ATK-1/SeniorDesign_SwanGanz/README.md

# Swan Ganz Interface

### Introduction

The contributors to this senior design project were Nathan DeLaRosa, Ashton Knecht, Jack Son, and Jerry Xia under the supervision of Dr. Jonathan Valvano.

This project aims to create a custom, low-cost interface for a Swan-Ganz heart catheter, bypassing the need for expensive cardiac output computers. The catheters intended to be interfaced are the *part number needed* produced by Edwards Lifescience. These catheters interface the *part number needed* pressure transducer, also made by Edwards Lifescience.

The project is split into three sections: the interface hardware, MSPM0 firmware, and the desktop application software. Details about each of these sections can be found in their distinct README files.

[Hardware README(In Progresss)](https://github.com/ATK-1/SeniorDesign_SwanGanz/blob/main/hardware/README.md)

[Firmware README(Requires Development)](https://github.com/ATK-1/SeniorDesign_SwanGanz/blob/main/firmware/README.md)

[Software README(Requires Development)](https://github.com/ATK-1/SeniorDesign_SwanGanz/blob/main/SwanGanzApp/README.md)

### Testing and Verification
*todo*
