ATK-1/SeniorDesign_SwanGanz/firmware/SwanGanz/inc/fftdesign.xlsx

Sheet: cos
speed up using table look up
w.Real = cos(2*PI*m/(float)n);
w.Imag = -sin(2*PI*m/(float)n);
n is 2,4,8,16,32,64,128,256,512,1024,2048,4096
m goes from 0 to n/2
w.Real | n, j=0 | 1 | 2 | 3 | 4 | 5 | 6 | 7 | 8 | 9 | 10 | 11
m | 2 | 4 | 8 | 16 | 32 | 64 | 128 | 256 | 512 | 1024 | 2048 | 4096
0 | 1.00000000 | 1.00000000 | 1.00000000 | 1.00000000 | 1.00000000 | 1.00000000 | 1.00000000 | 1.00000000 | 1.00000000 | 1.00000000 | 1.00000000 | 1.00000000 | const float cosTab[2048][12]={
1 | -1.00000000 | 6.125742275e-17 | 0.70710678 | 0.92387953 | 0.98078528 | 0.99518473 | 0.99879546 | 0.99969882 | 0.99992470 | 0.99998118 | 0.99999529 | 0.99999882 | {1.00000000, 1.00000000, 1.00000000, 1.00000000, 1.00000000, 1.00000000, 1.00000000, 1.00000000, 1.00000000, 1.00000000, 1.00000000, 1.00000000},
2 | 1.00000000 | -1.00000000 | 6.125742275e-17 | 0.70710678 | 0.92387953 | 0.98078528 | 0.99518473 | 0.99879546 | 0.99969882 | 0.99992470 | 0.99998118 | 0.99999529 | {-1.00000000, 0.00000000, 0.70710678, 0.92387953, 0.98078528, 0.99518473, 0.99879546, 0.99969882, 0.99992470, 0.99998118, 0.99999529, 0.99999882},
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
