ATK-1/SeniorDesign_SwanGanz/hardware/SGI_BOM_v1.0.xlsx

Reference | Part Number | Quantity | Mouser PN | Manufacturer | Value | Rating | Footprint | Tolerance | Type | Price for 1
C1, C3, C4, C5, C6, C7, C8, C9, C10, C13, C14, C17, C18, C21 | CC0603JRX7R9BB104 | 14 | 603-CC0603KRX7R9BB104 | YAGEO | 0.1uF | 50 VDC | 0603 | 5% | X7R | $0.10
C2 | C1206C106J3RACTU | 1 | 80-C1206C106J3RACTU | KEMET | 10uF | 25 VDC | 1206 | 5% | X7R | $0.94
C11, C12, C15, C16, C19, C20 | GRT31C5C1H104FA02L | 6 | 81-GRT31C5C1H104FA2L | Murata | 0.1uF | 25 VDC | 1206 | 1% | C0G | $0.91
D1, D2, D3 | HLMP-4700 | 3 | 630-HLMP-4700 | Broadcom/Avago | Red
Q1 | SQ2389CES-T1_GE3 | 1 | 78-SQ2389CES-T1_GE3 | Vishay/Siliconix | N/A | 40 Vds | SOT-23-3 | N/A | P-channel | $0.68
R1, R2 | CR0603-FX-5101ELF | 2 | 652-CR0603FX-5101ELF | Bourns | 5.1k | 75 V | 0603 | 1% | Thick film | $0.10
R3 | CRCW060347K0FKED | 1 | 71-CRCW060347K0FKED | Vishay | 47k | 75 V | 0603 | 1% | Thick film | $0.25
R4,R20, R21, R22, R23, R27, R28, R29, R34, R35, R36 | RCA060310K0FKEC | 11 | 71-RCA060310K0FKEC | Vishay/Draloric | 10k | 75 V | 0603 | 1% | thick film | $0.11
R5 | TNPW06031K00FHTA | 1 | 71-TNPW06031K00FHTA | Vishay | 1k | 75 V | 0603 | 1% | thin film | $0.39
R6, R7, R8 | 1879246-3 | 3 | 571-1879246-3 | TE Connectivity | 5k | 50 V | 0603 | 1% | thin film | $0.31
R9, R14, R16 | RCA0603100KFKEC | 4 | 71-RCA0603100KFKEC | Vishay | 100k | 75 V | 0603 | 1% | Thick film | $0.11
R10, R13 | AC0603FRE07100RL | 2 | 603-AC0603FRE07100RL | YAGEO | 100 | 75 V | 0603 | 1% | Thick film | $0.10
R11, R12 | CRCW06030000Z0EI | 2 | 71-CRCW06030000Z0EI | Vishay | 0 | 75 V | 0603 | N/A | Thick film | $0.21
R15 | CR0603-FX-8201ELF | 1 | 652-CR0603FX-8201ELF | Bourns | 8.2k | 75 V | 0603 | 1% | Thick film | $0.10
R17 | RT0603DRD0765K5L | 1 | 603-RT0603DRD0765K5L | YAGEO | 65.5k | 75 V | 0603 | 0.5% | thin film | $0.10
R18, R19 | RT0603DRE07160KL | 2 | 603-RT0603DRE07160KL | YAGEO | 160k | 75 V | 0603 | 0.5% | thin film | $0.11
R24, R31 | RC0603FR-10200RL | 2 | 603-RC0603FR-10200RL | YAGEO | 200 | 75 V | 0603 | 1% | Thick film | $0.12
R25, R26, R32, R33 | RN73R1JTTD3202F50 | 4 | 660-RN73R1JTD3202F50 | KOA SPEER | 32k | 75 V | 0603 | 1% | thin film | $0.10
R30, R37 | CRCW060317K4FKEAC | 2 | 71-CRCW060317K4FKEAC | Vishay | 17.4k | 75 V | 0603 | 1% | thick film | $0.10
SW1 |  | 1
SW2, SW3 |  | 2
U8, U10, U12 | INA122UA/2K5 | 3 | 595-INA122UA/2K5 | Texas Instruments | N/A | N/A | SOIC-8 | N/A | IC | $6.72
