ATK-1/SeniorDesign_SwanGanz/hardware/SwanGanzInterface_V1.1/SwanGanzInterface_v1.1_PinAllocation.xlsx

Sheet: Device Comparision
Part Number | Flash (KB) | SRAM (KB) | ADC | ADC Channels | COMP | TIMA | TIMG | GPIO | Number of Pins | Package | Size
M0G3507QPMRQ1 | 128 | 32 | 2 | 17 | 3 | 2 | 5 | 60 | 64 | 64 LQFP | 12mm x 12mm
M0G3507QPTRQ1 | 128 | 32 | 2 | 16 | 3 | 2 | 5 | 44 | 48 | 48 LQFP | 9mm x 9mm
M0G3507QRGZRQ1 | 128 | 32 | 2 | 16 | 3 | 2 | 5 | 44 | 48 | 48 VQFN | 7mm x 7mm
M0G3507QRHBRQ1 | 128 | 32 | 2 | 11 | 3 | 2 | 5 | 28 | 32 | 32 VQFN | 5mm x 5mm
M0G3507QDGS32RQ1 | 128 | 32 | 2 | 11 | 3 | 2 | 5 | 28 | 32 | 32 VSSOP | 8.1mm x 4.9mm
M0G3507QDGS28RQ1 | 128 | 32 | 2 | 11 | 3 | 2 | 5 | 24 | 28 | 28 VSSOP | 7.1mm x 3mm

Sheet: Pin Requirements
Pin Name | QTY | Discription | TRM SECTION | TRM PAGE | PT - Assigned
HFXTIN | 1 | Input for high-frequency crystal oscillator | 2.3.1.6 High Frequency Crystal Oscillator (HFXT) | 231
HFXOUT | 1 | Output for high-frequency crystal oscillator | 2.3.1.6 High Frequency Crystal Oscillator (HFXT) | 231
ROSC | 1 | External resistor used for improiving oscillator accuracy
Therm_ADC | 2 | ADC inputs for thermistor circuit
P1_ADC | 2 | ADC inputs for p1 circuit
P2_ADC | 2 | ADC inputs for p2 circuit
LCD_SCLK | 1 | SPI SysClk for LCD driver
LCD_MISO | 1 | SPI MISO for LCD driver
LCD MOSI | 1 | SPI MOSI for LCD driver
LCD_CS | 1 | GPIO chip select for LCD driver
LCD_RST | 1 | GPIO reset for LCD driver
LCD_WAIT | 1 | GPIO input specifiying the busy state of the LCD driver
LCD_INT | 1 | GPIO input specifiying the interrupt status of LCD driver
LCD_TS | 4 | ADC inputs for LCD touch screen
UART_Rx | 1 | UART receive for UART to USB converter
UART_Tx | 1 | UART transmit for UART to USB converter
USB_CONN | 1 | GPIO input to determine if USB is connected
SW_IN | 2 | GPIO inputs for tactile switches
LED | 2 | GPIO outputs to control LED outputs
Debug GPIO | 8 | GPIO outputs for debugging
SWCLK | 1 | Serial wire debug input clock
SWDIO | 1 | Serial wire debug data input/output
Total | 37

Sheet: PM - 64 LQFP
Pin | Pin Function | SGI v1.1 Function | Pin Function Select | Placed
1 | PB13 | LCD_Backlite | GPIO - Output
2 | PB14 | DBG1 | GPIO - Output
3 | PB15 | DBG2 | GPIO - Output
4 | PB16 | DBG3 | GPIO - Output
5 | PA12 / FCC_IN | DBG4 | GPIO - Output
6 | PA13 | DBG5 | GPIO - Output
7 | PA14 / CLK_OUT / A0.12 | SPEAKER_CD | GPIO - Output
8 | PA15 / A1.0 | SPEAKER_DAC | DAC_OUT
9 | PA16 / A1.1 / FCC_IN | P1_LG | A1.1
10 | PA17 / A1.2 | P1_HG | A1.2
11 | PA18 / A1.3 | LED_WORKING | GPIO - Output
12 | PA19 / SWDIO | SWDIO | SWDIO
13 | PA20 / SWCLK | SWCLK | SWCLK
14 | PB17 / A1.4 | P2_LG | A1.4
15 | PB18 / A1.5 | P2_HG | A1.5
16 | PB19 / A1.6 | LED_ERROR | GPIO - Output
17 | PA21 / A1.7 / VREF- | VREF- | VREF-
18 | PA22 / CLK_OUT / A0.7 | DBG6
19 | PB20 / A0.6 | SW_UP | GPIO - Input
20 | PB21 | SW_DOWN | GPIO - Input
21 | PB22 | SW_ENTER | GPIO - Input
22 | PB23
23 | PB24 / A0.5
24 | PA23 / VREF+ | VREF+ | VREF+
25 | PA24 / A0.3 | DBG7
26 | PA25 / A0.2 | DBG8
27 | PB25 / A0.4 | UART0_CTS | FT232_RTS
28 | PB26 | UART0_RTS | FT232_CTS
29 | PB27
30 | PA26 / A0.1 | T_LG | A0.0
31 | PA27 / A0.0 | T_HG | A0.1
32 | VCORE | VCORE | VCORE
33 | PA0 / FCC_IN
34 | PA1 | FT232_TX | UART0_RX
35 | PA28 | FT232_RX | UART0_TX
36 | PA29 | FT232_RST | GPIO - Output
37 | PA30 | USB_CONN | GPIO - Input
38 | NRST | VDD | NRST
39 | PA31 / CLK_OUT
40 | VDD | VDD | VDD
41 | VSS | VSS | VSS
42 | PA2 / ROSC | ROSC | ROSC
43 | PA3 / LFXIN
44 | PA4 / LFCLK_IN / LFXOUT
45 | PA5 / HFXIN / FCC_IN | HFXIN | HFXIN
46 | PA6 / HFCLK_IN / HFXOUT | HFXOUT | HFXOUT
47 | PB0
48 | PB1
49 | PA7 / CLK_OUT
50 | PB2
51 | PB3
52 | PB4 | TOUCH_BUSY | GPIO - Input
53 | PB5 | PENIRQ | GPIO - Input
54 | PA8 | TOUCH_CS | SPI0_CS0
55 | PA9 / RTC_OUT / CLK_OUT | TOUCH_PICO | SPI0_PICO
56 | PA10 / CLK_OUT | TOUCH_POCI | SPI0_POCI
57 | PA11 | TOUCH_SCK | SPI0_SCK
58 | PB6 | LCD_CS | SPI1_CS0
59 | PB7 | LCD_POCI | SPI1_POCI
60 | PB8 | LCD_PICO | SPI1_PICO
61 | PB9 | LCD_SCLK | SPI11_SCK
62 | PB10 | LCD_INT | GPIO - Input
63 | PB11 / CLK_OUT | LCD_WAIT | GPIO - Input
64 | PB12 | LCD_RST | GPIO - Output

Sheet: PT - 48 LQFP
Pin Number | Pin Function | SGI v1.1 Function | Pin Function Select | Translated
1 | PA0 / FCC_IN
2 | PA1
3 | PA28 | DEBUG1 | GPIO - Output
4 | NRST | VDD | NRST
5 | PA31 / CLK_OUT | DEBUG2 | GPIO - Output
6 | VDD | VDD | VDD
7 | VSS | VSS | VSS
8 | PA2 / ROSC | ROSC | ROSC
9 | PA3 / CMP1_OUT / LFXIN | SW_MODE | GPIO - Input
10 | PA4 / LFCLK_IN / LFXOUT | SW_ENTER | GPIO - Input
11 | PA5 / HFXIN / FCC_IN | HFXIN | HFXIN
12 | PA6 / HFCLK_IN / HFXOUT | HFXOUT | HFXOUT
13 | PA7 / CLK_OUT | DEBUG3 | GPIO - Output
14 | PB2 | USB_CTS | UART1_CTS
15 | PB3 | USB_RTS | UART1_RTS
16 | PA8 | USB_Tx | UART1_TX
17 | PA9 / RTC_OUT / CLK_OUT | USB_Rx | UART1_RX
18 | PA10 / CLK_OUT | USB_CONN | GPIO - Input
19 | PA11 | DEBUG 4 | GPIO OUTPUT
20 | PB6 | LCD_CS | SPI1_CS0
21 | PB7 | LCD_POCI | SPI1_POIC
22 | PB8 | LCD_PICO | SPI1_PICO
23 | PB9 | LCD_SCLK | SPI1_SCK
24 | PB14 | LCD_WAIT | GPIO - Input
25 | PB15 | LCD_RST | GPIO - Output
26 | PB16 | LCD_INT | GPIO - Input
27 | PA12 / FCC_IN | TOUCH_SCK | SPI0_SCK |  | DEBUG 5 | GPIO - Output
28 | PA13 | TOUCH_POCI | SPI0_POCI |  | DEBUG 6 | GPIO - Output
29 | PA14 / CLK_OUT / A0.12 | TOUCH_PICO | SPI0_PICO |  | DEBUG 7 | GPIO - Output
30 | PA15 / A1.0 | SPEAKER | DAC
31 | PA16 / A1.1 / FCC_IN | PENIRQ | GPIO - Input
32 | PA17 / A1.2
33 | PA18 / A1.3 | P1_LG | A1.3
34 | PA19 / SWDIO | SWDIO | SWDIO
35 | PA20 / SWCLK | SWCLK | SWCLK
36 | PB17 / A1.4 | P1_HG | A1.4
37 | PB18 / A1.5 | P2_LG | A1.5
38 | PB19 / A1.6 | P2_HG | A1.6
39 | PA21 / A1.7 / VREF- | VREF- | VREF-
40 | PA22 / CLK_OUT / A0.7 | DEBUG 8 | GPIO - Output
41 | PB20 / A0.6 | LED_WORKING | GPIO - Output
42 | PB24 / A0.5 | LED_ERROR | GPIO - Output
43 | PA23 / VREF+ | VREF+ | VREF+
44 | PA24 / A0.3 | TOUCH_CS | SPI0_CS3
45 | PA25 / A0.2 / OPA0_IN+
46 | PA26 / A0.1 | THERM_HG | A0.1
47 | PA27 / RTC_OUT / A0.0 | THERM_LG | A0.0
48 | VCORE | VCORE | VCORE

Sheet: DGS28 - 28 VSSOP
Pin Number | Pin Function | SGI v1.1 Funciton
1 | PA26 / A0.1
2 | PA27 / RTC_OUT / A0.0
3 | VCORE
4 | PA0
5 | PA1
6 | NRST
7 | VDD
8 | VSS
9 | PA2 / ROSC
10 | PA3 / LFXIN
11 | PA4 / LFCLK_IN / LFXOUT
12 | PA5 / HFXIN / FCC_IN
13 | PA6 / HFCLK_IN / HFXOUT
14 | PA9 / RTC_OUT / CLK_OUT
15 | PA10 / CLK_OUT
16 | PA11
17 | PA14 / CLK_OUT / A0.12
18 | PA15 / A1.0
19 | PA16 / A1.1 / FCC_IN
20 | PA17 / A1.2
21 | PA18 / A1.3
22 | PA19 / SWDIO
23 | PA20 / SWCLK
24 | PA21 / A1.7 / VREF-
25 | PA22 / CLK_OUT / A0.7
26 | PA23 / VREF+
27 | PA24 / A0.3
28 | PA25 / A0.2

Sheet: Pin Allocation v1.0
Pin | Purpose | isAllocated
PA8 | UART_TX | 1
PA10 | DEBUG | 1
PA11 | DEBUG | 1
PA12 | DEBUG | 1
PA13 | DEBUG | 1
PA15 | LED | 1
PA16 | LED | 1
PA17 | PC2_LG | 1
PA18 | PC2_HG | 1
PA22 | THERM_HG | 1
PA24 | PC1_HG | 1
PA25 | PC1_LG | 1
PA26 | NA | 0
PA27 | NA | 0
PA28 | DEBUG | 1
PA31 | DEBUG | 1
PB0 | NA | 0
PB1 | LCD_WAIT | 1
PB2 | NA | 0
PB3 | PB3 | 1
PB4 | LCD_INT | 1
PB6 | LCD_CS | 1
PB7 | LCD_MISO | 1
PB8 | LCD_MOSI | 1
PB9 | LCD_SCLK | 1
PB12 | SW_MODE | 1
PB13 | SW_ENTER | 1
PB15 | LCD_RST | 1
PB16 | NA | 0
PB17 | DEBUG | 1
PB18 | NA | 0
PB19 | NA | 0
PB20 | DEBUG | 1
PB23 | UART_RX | 1
PB24 | THERM_LG | 1
 | SUM : | 28
