ATK-1/SeniorDesign_SwanGanz/hardware/SwanGanzInterface_V1.1/SwanGanzInterface_V1.1.kicad_pcb

## KiCad design hardware/SwanGanzInterface_V1.1/SwanGanzInterface_V1.1.kicad_pcb (2026-03-31)

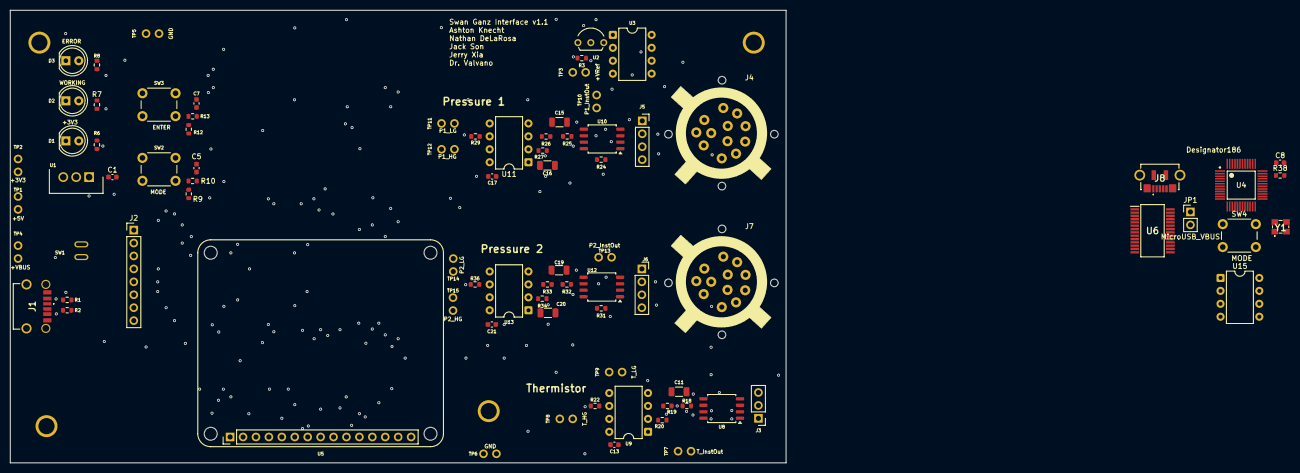
[picture p1: board SwanGanzInterface_V1.1.kicad_pcb from above]

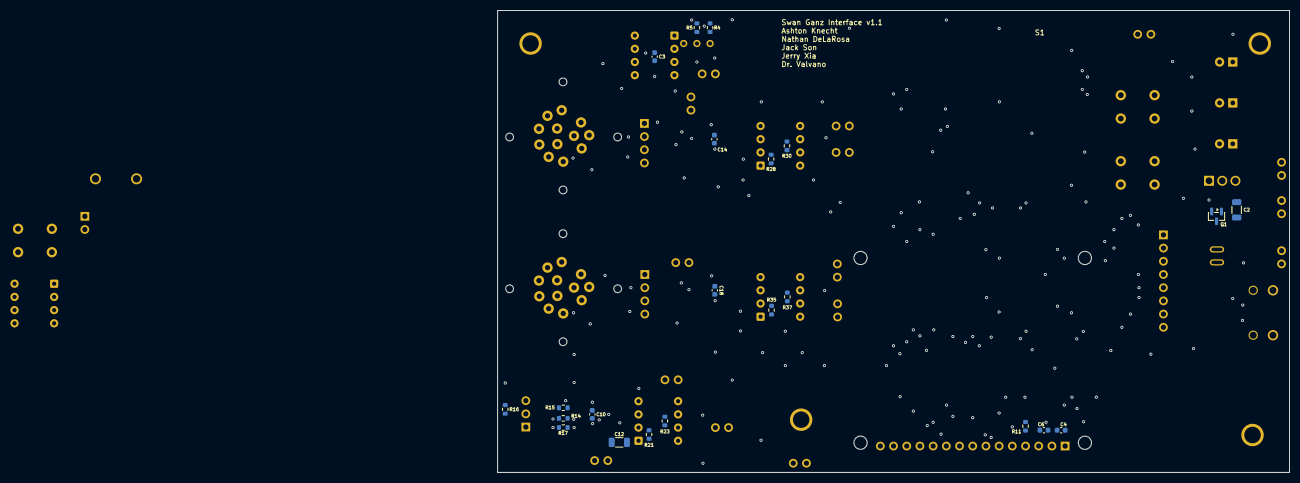
[picture p2: board SwanGanzInterface_V1.1.kicad_pcb from below]

Board: 2 copper layers, 152.4 x 88.9 mm, 108 parts (22 on the bottom side), 86 nets, no tracks yet.

Parts:
C1, C3, C4, C5, C6, C7, C10, C13, C14, C17, C18, C21: 0.1u; C_0603_1608Metric
C2: 10u; C_1206_3216Metric
C8: 0.01u; C_0603_1608Metric
C11, C12, C15, C16, C19, C20: 0.1u; C_1206_3216Metric
D1: +3V3; LED_D5.0mm
D2: WORKING; LED_D5.0mm
D3: ERROR; LED_D5.0mm
H1, H2, H3, H4: MountingHole_4_40
J1: 2479774-1; 24797741
J2: Conn_01x08_Pin; PinHeader_1x08_P2.54mm_Vertical
J3: Conn_01x03_Pin; PinHeader_1x03_P2.54mm_Vertical
J4, J7: Pressure_Connector_1.1
J5, J6: Conn_01x04_Pin; PinSocket_1x04_P2.54mm_Vertical
J8: 1051640001
JP1: MicroUSB_VBUS; PinHeader_1x02_P2.54mm_Vertical
Q1: SQ2389CES-T1_GE3; SOT-23
R1, R2: 5k1; R_0603_1608Metric
R3, R38: 47k; R_0603_1608Metric
R4, R20, R21, R22, R23, R27, R28, R29, R34, R35, R36: 10k; R_0603_1608Metric
R5: 1k; R_0603_1608Metric
R6, R7, R8: 5k; R_0603_1608Metric
R9, R12, R14, R16: 100k; R_0603_1608Metric
R10, R13: 100R; R_0603_1608Metric
R11: 0R; R_0603_1608Metric
R15: 8k2; R_0603_1608Metric
R17: 65k5; R_0603_1608Metric
R18, R19: 160k; R_0603_1608Metric
R24, R31: 200R; R_0603_1608Metric
R25, R26, R32, R33: 32k; R_0603_1608Metric
R30, R37: 17k5; R_0603_1608Metric
SW1: Power_Switch; SW-T3-1A-A-A3-S1
SW2, SW4: MODE; SW_PUSH_6mm
SW3: ENTER; SW_PUSH_6mm
TP1: +5V; Testpoint_1x02_P2.54mm
TP2: +3V3; Testpoint_1x02_P2.54mm
TP3: +VRef; Testpoint_1x02_P2.54mm
TP4: +VBUS; Testpoint_1x02_P2.54mm
TP5, TP6: GND; Testpoint_1x02_P2.54mm
TP7: T_InstOut; Testpoint_1x02_P2.54mm
TP8: T_HG; Testpoint_1x02_P2.54mm
TP9: T_LG; Testpoint_1x02_P2.54mm
TP10: P1_InstOut; Testpoint_1x02_P2.54mm
TP11: P1_LG; Testpoint_1x02_P2.54mm
TP12: P1_HG; Testpoint_1x02_P2.54mm
TP13: P2_InstOut; Testpoint_1x02_P2.54mm
TP14: P2_LG; Testpoint_1x02_P2.54mm
TP15: P2_HG; Testpoint_1x02_P2.54mm
U1: LM2937ET-3.3_NOPB; TO254P470X1028X1955-3P
U2: LM4041CILPR; ti_LM4041CILPR
U3, U9, U11, U13, U15: OPA2350; DIP-8_W7.62mm
U4: XM0G3507QPTRQ1; MSPM0_PT0048A-IPC_A
U5: AdaFruit_1590
U6: FT232RL
U8, U10, U12: INA122D; SOIC-8_5.3x5.3mm_P1.27mm
Y1: ABM8AIG-40.000MHZ-12-2Z-T3; ABM8AIG25000MHZ122ZT3

Connections:
+3V3: C2.1, C3.1, C4.1, C10.2, C13.1, C14.2, C17.1, C18.2, C21.1, R5.1, R6.1, R9.1, R11.1, R12.1, R14.1, R16.1, R38.1, TP2.1 (A), TP2.2 (B), U1.3 (OUTPUT), U3.8 (V+), U4.6 (VDD), U5.1 (VIN), U8.7 (+VS), U9.8 (V+), U10.7 (+VS), U11.8 (V+), U12.7 (+VS), U13.8 (V+), U15.8 (V+)
+5V: C1.1, Q1.2 (S), TP1.1 (A), TP1.2 (B), U1.1 (INPUT), U6.20 (VCC)
+VBUS: J1.A9 (VBUS_1), J1.B9 (VBUS_2), JP1.1 (A), SW1.1 (A), TP4.1 (A), TP4.2 (B)
+VRef: R3.1, R5.2, TP3.1 (A), TP3.2 (B), U2.2, U3.3 (+), U3.5 (+)
BACKLITE: C6.1, R11.2, U5.4 (LITE)
DEBUG1_PA28: J2.1, U4.3 (PA28)
DEBUG2_PA31: J2.2, U4.5 (PA31_CLK_OUT)
DEBUG3_PA7: J2.3, U4.13 (PA7_CLK_OUT)
DEBUG4_PA11: J2.4, U4.19 (PA11)
DEBUG5_PA12: J2.5, U4.27 (PA12_FCC_IN)
DEBUG6_PA13: J2.6, U4.28 (PA13)
DEBUG7_PA14: J2.7, U4.29 (PA14_CLK_OUT_A0_12)
DEBUG8_PA22: J2.8, U4.40 (PA22_CLK_OUT_A0_7)
FT_+3V3: U6.4 (VCCIO), U6.17 (3V3OUT)
GND: C1.2, C2.2, C3.2, C4.2, C5.2, C6.2, C7.2, C8.2, C10.1, C11.2, C13.2, C14.1, C15.2, C17.2, C18.1, C19.2, C21.2, D1.1 (K), D2.1 (K), D3.1 (K), J1.A12 (GND_1), J1.B12 (GND_2), J3.3, J4.4 (VDD), J5.4, J6.4, J7.4 (VDD), J8.5 (GND), Q1.1 (G), R1.2, R2.2, R4.2, R15.2, R20.1, R22.1, R27.1, R29.1, R34.1, R36.1, SW2.1, SW3.1, SW4.1, TP5.1 (A), TP5.2 (B), TP6.1 (A), TP6.2 (B), U1.2 (GND), U2.3, U3.4 (V-), U4.7 (VSS), U4.39 (PA21_A1_7_VREF-), U5.2 (GND), U6.7 (GND_1), U6.18 (GND_2), U6.21 (GND_3), U6.25 (AGND), U6.26 (TEST), U8.4 (-VS), U8.5 (REF), U9.4 (V-), U10.4 (-VS), U10.5 (REF), U11.4 (V-), U12.4 (-VS), U12.5 (REF), U13.4 (V-), U15.4 (V-), Y1.2 (GND_1), Y1.4 (GND_2)
HFXIN: U4.11 (PA5_HFXIN_FCC_IN), Y1.1 (X1)
HFXOUT: U4.12 (PA6_HFCLK_IN_HFXOUT), Y1.3 (X2)
LCD_CS_PB6: U4.20 (PB6), U5.8 (CS)
LCD_INT_PB16: U4.26 (PB16), U5.11 (INT)
LCD_PICO_PB8: U4.22 (PB8), U5.7 (MOSI)
LCD_POCI_PB7: U4.21 (PB7), U5.6 (MISO)
LCD_RST_PB15: U4.25 (PB15), U5.9 (RST)
LCD_SCK_PB9: U4.23 (PB9), U5.5 (SCK)
LCD_WAIT_PB14: U4.24 (PB14), U5.10 (WAIT)
LCD_X+_A0.3: U4.44 (PA24_A0_3), U5.15 (X+)
LCD_X-_A0.2: U4.45 (PA25_A0_2_OPA0_IN1+), U5.14 (X-)
LCD_Y+_A0.1: U4.46 (PA26_A0_1), U5.12 (Y+)
LCD_Y-_A0.0: U4.47 (PA27_RTC_OUT_A0_0), U5.13 (Y-)
LED_ER_PB24: R8.1, U4.42 (PB24_A0_5)
LED_WRK_PB20: R7.1, U4.41 (PB20_A0_6)
MSP_NRST: C8.1, R38.2, SW4.2, U4.4 (RST_N)
MSP_RX_PA9_FT232_TX: U4.17 (PA9_RTC_OUT_CLK_OUT), U6.1 (TXD)
MSP_TX_PA8_FT232_RX: U4.16 (PA8), U6.5 (RXD)
unnamed: C12.1, R18.2, R19.1
unnamed: C16.1, R25.2, R26.1
unnamed: C20.1, R32.2, R33.1
unnamed: D1.2 (A), R6.2
unnamed: D2.2 (A), R7.2
unnamed: D3.2 (A), R8.2
unnamed: J1.A5 (CC1), R1.1
unnamed: J1.B5 (CC2), R2.1
unnamed: J3.2, R16.2, U8.3 (+IN)
unnamed: J8.1 (VBUS), JP1.2 (B)
unnamed: Q1.3 (D), SW1.2 (B)
unnamed: R3.2, R4.1, U2.1
unnamed: R9.2, R10.1, SW2.2
unnamed: R12.2, R13.1, SW3.2
unnamed: R14.2, R15.1, U8.2 (-IN)
unnamed: R17.1, U8.1 (RG+)
unnamed: R17.2, U8.8 (RG-)
unnamed: C11.1, R19.2, U9.3 (+)
unnamed: R20.2, R21.1, U9.2 (-)
unnamed: R22.2, R23.1, U9.6 (-)
unnamed: R24.1, U10.1 (RG+)
unnamed: R24.2, U10.8 (RG-)
unnamed: C15.1, R26.2, U11.3 (+)
unnamed: R27.2, R28.1, U11.2 (-)
unnamed: R29.2, R30.1, U11.6 (-)
unnamed: R31.1, U12.1 (RG+)
unnamed: R31.2, U12.8 (RG-)
unnamed: C19.1, R33.2, U13.3 (+)
unnamed: R34.2, R35.1, U13.2 (-)
unnamed: R36.2, R37.1, U13.6 (-)
unnamed: U15.1, U15.2 (-)
P1_HG_ADC_1.4: R30.2, TP12.1 (A), TP12.2 (B), U4.36 (PB17_A1_4), U11.7
P1_LG_ADC_1.3: C16.2, R28.2, TP11.1 (A), TP11.2 (B), U4.33 (PA18_A1_3), U11.1, U11.5 (+)
P1_SIG+: J4.2 (SIG+), J5.2, U10.3 (+IN)
P1_SIG-: J4.3 (SIG-), J5.3, U10.2 (-IN)
P1_VCC: J4.1 (VCC), J5.1, U3.1, U3.2 (-)
P1__InstrOut: R25.1, TP10.1 (A), TP10.2 (B), U10.6 (OUT)
P2_HG_ADC_1.6: R37.2, TP15.1 (A), TP15.2 (B), U4.38 (PB19_A1_6), U13.7
P2_LG_ADC_1.5: C20.2, R35.2, TP14.1 (A), TP14.2 (B), U4.37 (PB18_A1_5), U13.1, U13.5 (+)
P2_SIG+: J6.2, J7.2 (SIG+), U12.3 (+IN)
P2_SIG-: J6.3, J7.3 (SIG-), U12.2 (-IN)
P2_VCC: J6.1, J7.1 (VCC), U3.6 (-), U3.7
P2__InstrOut: R32.1, TP13.1 (A), TP13.2 (B), U12.6 (OUT)
SW_ENTER_PA4: C7.1, R13.2, U4.10 (PA4_LFCLK_IN_LFXOUT)
SW_MODE_PA3: C5.1, R10.2, U4.9 (PA3_COMP1_OUT_LFXIN)
THERM_LG_ADC_1.1: C12.2, R21.2, TP9.1 (A), TP9.2 (B), U4.31 (PA16_A1_1_FCC_IN), U9.1, U9.5 (+)
THERM__HG_ADC_1.2: R23.2, TP8.1 (A), TP8.2 (B), U4.32 (PA17_A1_2), U9.7
Therm__InstrOut: R18.1, TP7.1 (A), TP7.2 (B), U8.6 (OUT)
USB_D+: J8.3 (D+), U6.15 (USBDP)
USB_D-: J8.2 (D-), U6.16 (USBDM)
USB_MP: J8.MH1, J8.MH2, J8.MP1, J8.MP2, J8.MP3, J8.MP4
USB_MSP_CTS_PB2_RS232_RTS: U4.14 (PB2), U6.3 (RTS#)
USB_MSP_RTS_PB3_RS232_CTS: U4.15 (PB3), U6.11 (CTS#)
