ATK-1/SeniorDesign_SwanGanz/firmware/SwanGanz/Display.c

#include <ti/devices/msp/msp.h>
#include <string.h>
#include "OS.h"
#include "Display.h"
#include "Conversions.h"
#include "RA8875.h"
#include "DAS.h"
#include "Data.h"

#define NUM_CHANNELS 6


static int input;
uint32_t Started;
uint32_t OtherButton;

void DisplayInit() {
    if (!RA8875_begin(RA8875_800x480)) {
        while(1) {} // LCD Initialization failed
    }
    RA8875_displayOn(1);
    RA8875_setGPIOX(1);
    RA8875_PWM1config(1, 0);
    RA8875_PWM1out(255);
     
    RA8875_fillScreen(BCKGRND_COLOR);
    

    OS_InitSemaphore(&LCD_Mutex, 1);
    OS_InitSemaphore(&CurrReadingsKilled, 0);
    OS_InitSemaphore(&newVals.ready, 0);
}

void DisplayResults() {
    OS_bWait(&LCD_Mutex);

    uint32_t headerRectX = SPACING;
    uint32_t headerRectY = SPACING;
    uint32_t headerRectW = SCREEN_W - SPACING * 2;
    uint32_t headerRectH = 80;
    RA8875_fillRoundRect(headerRectX, headerRectY, headerRectW, headerRectH, CORNER_ROUNDNESS, UT_COLOR);
    
    const char* resultsHeaderStr = "Thermodilution Results";
    const uint32_t resultsHeaderStrW = 525;
    const uint32_t resultsHeaderStrH = 33;
    const uint32_t resultsHeaderStrX = headerRectX + ((headerRectW - resultsHeaderStrW) >> 1);
    const uint32_t resultsHeaderStrY = ((headerRectH - resultsHeaderStrH) >> 1) - SPACING;
    RA8875_textEnlarge(2);
    RA8875_textTransparent(RA8875_BLACK);
    RA8875_textSetCursor(resultsHeaderStrX, resultsHeaderStrY);
    RA8875_textWrite(resultsHeaderStr, strlen(resultsHeaderStr));

    const char* flowStr = "Calculated Flow:";
    const uint32_t flowStrW = 375;
    const uint32_t flowStrH = 50;
    const uint32_t flowStrX = (SCREEN_W - (flowStrW + 240)) >> 1;
    const uint32_t flowStrY = 175;
    RA8875_textSetCursor(flowStrX, flowStrY);
    RA8875_textWrite(flowStr, strlen(flowStr));
    
    int32_t flowVal = getFlowRate();
    uint32_t negative1 = !(flowVal & 0xFFFFFFFF00000000) && (flowVal & 0x80000000);
    uint32_t negative2 = (flowVal & 0x8000000000000000) >> 32;
    uint32_t flowValStrX = flowStrX + flowStrW + (SPACING * 2);
    if (negative1 || negative2) {
        RA8875_textSetCursor(flowStrX, flowStrY + 50);
        RA8875_textWrite("-", 1);
        flowValStrX += 50;
        if (negative1) {
            flowVal |= 0xFFFFFFFF00000000;
        }
        flowVal = ~flowVal + 1;
    }
    if (flowVal >= 1000) {
        char flowValStr[5] = "0000";
        FourDigUIntToFixedStr(flowVal, flowValStr);
        RA8875_textSetCursor(flowValStrX, flowStrY);
        RA8875_textWrite(flowValStr, strlen(flowValStr));
        //RA8875_drawRect(flowStrX, flowStrY, 476, 50, RA8875_BLACK);
    }
    else {
        char flowValStr[4] = "000";
        ThreeDigUIntToFixedStr(flowVal, flowValStr);
        RA8875_textSetCursor(flowValStrX, flowStrY);
        RA8875_textWrite(flowValStr, strlen(flowValStr));
    }
    const char* unitsStr = "mL/Min";
    RA8875_textSetCursor(flowValStrX + 120, flowStrY);
    RA8875_textWrite(unitsStr, strlen(unitsStr));

    


    const char* AOCStr = "Area under the curve:";
    const uint32_t AOCStrW = 600;
    const uint32_t AOCStrX = (SCREEN_W - (AOCStrW + 20)) >> 1;;
    const uint32_t AOCStrY = flowStrY + 100;
    RA8875_textSetCursor(AOCStrX, AOCStrY);
    RA8875_textWrite(AOCStr, strlen(AOCStr));
    //RA8875_drawRect(AOCStrX, AOCStrY, 500, 50, RA8875_BLACK);

    uint32_t AOCVal = getAOC();
    uint32_t AOCValStrX = AOCStrX + AOCStrW - 80;
    if (AOCVal >= 1000) {
        char AOCValStr[5] = "0000";
        FourDigUIntToFixedStr(AOCVal, AOCValStr);
        RA8875_textSetCursor(AOCValStrX, AOCStrY);
        RA8875_textWrite(AOCValStr, strlen(AOCValStr));
        //RA8875_drawRect(flowStrX, flowStrY, 476, 50, RA8875_BLACK);
    }
    else {
        char AOCValStr[4] = "000";
        ThreeDigUIntToFixedStr(AOCVal, AOCValStr);
        RA8875_textSetCursor(AOCValStrX, AOCStrY);
        RA8875_textWrite(AOCValStr, strlen(AOCValStr));
    }
    // char AOCValStr[7] = "000000";
    // int64_t AOCVal = getAOC();
    // negative1 = !(AOCVal & 0xFFFFFFFF00000000) && (AOCVal & 0x80000000);
    // negative2 = (AOCVal & 0x8000000000000000) >> 32;
    // int32_t AOCValStrX = AOCStrX;
    // if (negative1 || negative2) {
    //     RA8875_textSetCursor(x, AOCStrY + 75);
    //     RA8875_textWrite("-", 1);
    //     x += 50;
    //     if (negative1) {
    //         AOCVal |= 0xFFFFFFFF00000000;
    //     }
    //     AOCVal = ~AOCVal + 1;
    // }
    // int64ToString(AOCVal, AOCValStr);
    // RA8875_textSetCursor(x, AOCStrY + 75);
    // RA8875_textWrite(AOCValStr, strlen(AOCValStr));

    // Reset button
    uint32_t resetButtonX = SCREEN_W - 260;
    uint32_t resetButtonY = SCREEN_H - 60;
    uint32_t resetButtonW = 250;
    uint32_t resetButtonH = 50;
    RA8875_fillRoundRect(resetButtonX, resetButtonY, resetButtonW, resetButtonH, CORNER_ROUNDNESS, 0xf5c2);
    
    const char* resetStr = "Reset";
    uint32_t resetStrW = 115;
    uint32_t resetStrH = 21;
    uint32_t resetStrX = resetButtonX + ((resetButtonW - resetStrW) >> 1);
    uint32_t resetStrY = resetButtonY - 3;
    RA8875_textSetCursor(resetStrX, resetStrY);
    RA8875_textTransparent(RA8875_BLACK);
    RA8875_textWrite(resetStr, strlen(resetStr));
    //RA8875_drawRect(resetStrX, resetStrY + 11, 115, 32, RA8875_BLACK);
    
    
    OS_bSignal(&LCD_Mutex);
    while (1) {
        uint32_t input = Fifo_Get(INPUT);
        if (input == RESET_BUTTON) {
            RA8875_fillScreen(BCKGRND_COLOR);
            __disable_irq();
            DASInit();
            OS_AddThread(&DisplayCurrentReadings, 2);
            OS_AddThread(&DisplayStartMenu, 2);
            OS_AddThread(&DisplayConnected, 2);
            OS_AddThread(&InitReadings, 1);
            OS_SetPerioidcSchedule(0);
            OS_Kill();
        }
    }
}
#define MEASURING_TIME_MS 40000
#define INJECTATE_TIME_MS 8000
void DisplayMeasuring() {
    OS_bWait(&LCD_Mutex);

    uint32_t headerRectX = SPACING;
    uint32_t headerRectY = SPACING;
    uint32_t headerRectW = SCREEN_W - SPACING * 2;
    uint32_t headerRectH = 80;
    RA8875_fillRoundRect(headerRectX, headerRectY, headerRectW, headerRectH, CORNER_ROUNDNESS, UT_COLOR);
    
    const char* thermoHeaderStr = "Thermodilution Calculation";
    const uint32_t thermoHeaderStrW = 620;
    const uint32_t thermoHeaderStrH = 33;
    const uint32_t thermoHeaderStrX = headerRectX + ((headerRectW - thermoHeaderStrW) >> 1);
    const uint32_t thermoHeaderStrY = ((headerRectH - thermoHeaderStrH) >> 1) - SPACING;
    RA8875_textEnlarge(2);
    RA8875_textTransparent(RA8875_BLACK);
    RA8875_textSetCursor(thermoHeaderStrX, thermoHeaderStrY);
    RA8875_textWrite(thermoHeaderStr, strlen(thermoHeaderStr));

    const char* progressStr = "Progress...";
    const uint32_t progressX = SPACING * 5;
    const uint32_t progressStrY = headerRectY + headerRectH + (SPACING * 4);
    const uint32_t progressStrH = 31;
    RA8875_textEnlarge(1);
    RA8875_textSetCursor(progressX, progressStrY);
    RA8875_textWrite(progressStr, strlen(progressStr));

    const uint32_t progressBarY = progressStrY + progressStrH + SPACING;
    const uint32_t progressBarW = SCREEN_W - (progressX * 2);
    const uint32_t progressBarH = 35;
    RA8875_fillRect(progressX, progressBarY, progressBarW, progressBarH, 0xbdf7);
    
    const char* injectateStr = "Injectate";
    const uint32_t injectateStrX = (SCREEN_W - (progressBarW >> 1)) >> 1;
    const uint32_t injecetateStrY = progressBarY + progressBarH + (SPACING * 4);
    const uint32_t injecetateStrH = 31;
    RA8875_textSetCursor(injectateStrX, injecetateStrY);
    RA8875_textTransparent(RA8875_BLACK);
    RA8875_textWrite(injectateStr, strlen(injectateStr));

    const uint32_t InjBarW = progressBarW >> 1;
    const uint32_t InjBarH = progressBarH;
    const uint32_t InjBarX = injectateStrX;
    const uint32_t InjBarY = injecetateStrY + injecetateStrH + SPACING;
    RA8875_fillRect(InjBarX, InjBarY, InjBarW, InjBarH, 0xbdf7);
    OS_bSignal(&LCD_Mutex);
    
    uint32_t currProgX = progressX + 3;
    uint32_t endProgX = progressX + progressBarW - 3;
    uint32_t msPerProgLine = MEASURING_TIME_MS / (endProgX - currProgX);

    uint32_t currInjX = InjBarX + 3;
    uint32_t endInjX = InjBarX + InjBarW - 3;
    uint32_t msPerInjLine = INJECTATE_TIME_MS / (endInjX - currProgX);

    uint32_t prevProgTime = OS_MsTime();
    uint32_t prevInjTime = prevProgTime;
    while (1) {
        uint32_t currTime = OS_MsTime();
        int32_t diffProgTime = currTime - prevProgTime;
        int32_t diffInjTime = currTime - prevInjTime;

        while (diffProgTime >= msPerProgLine && currProgX < endProgX) {
            OS_bWait(&LCD_Mutex);
            RA8875_drawLine(currProgX, progressBarY + 2, currProgX, progressBarY + progressBarH - 3, RA8875_BLACK);
            OS_bSignal(&LCD_Mutex);
            currProgX++;
            diffProgTime -= msPerProgLine;
            prevProgTime += msPerProgLine;
        }

        while (diffInjTime >= msPerInjLine && currInjX < endInjX) {
            OS_bWait(&LCD_Mutex);
            RA8875_drawLine(currInjX, InjBarY + 2, currInjX, InjBarY + InjBarH - 3, INJECTATE_COLOR);
            OS_bSignal(&LCD_Mutex);
            currInjX++;
            diffInjTime -= msPerInjLine;
            prevInjTime += msPerInjLine;
        }
        if ((currProgX < endProgX) || (currInjX < endInjX)) {
            OS_Sleep(50);
        }
        else {
            OS_bWait(&LCD_Mutex);
            RA8875_fillScreen(BCKGRND_COLOR);
            OS_bSignal(&LCD_Mutex);
            killTransfer();
            KillCurrentReadings();
            OS_AddThread(&DisplayResults, 2);
            signalAllDataFifos();
            OS_Kill();
        }        
    }
}
