ATK-1/SeniorDesign_SwanGanz/firmware/SwanGanz/LUT.h

#ifndef __LUT_H__
#define __LUT_H__  1


// Non-Switch PCB LUT
// const uint32_t TempHG_LUT[4096] = {
// 27814, 27810, 27807, 27803, 27799, 27796, 27792, 27789, 27785, 27782, 27778, 27775, 27771, 27768, 27764, 27761, 27757, 27753, 27750, 27746, 27743, 27739, 27736, 27732, 27729, 27725, 27722, 27718, 27715, 27711, 27708, 27704, 27700, 27697, 27693, 27690, 27686, 27683, 27679, 27676, 27672, 27669, 27665, 27662, 27658, 27655, 27651, 27648, 27644, 27640, 27637, 27633, 27630, 27626, 27623, 27619, 27616, 27612, 27609, 27605, 27602, 27598, 27595, 27591, 27588, 27584, 27581, 27577, 27574, 27570, 27566, 27563, 27559, 27556, 27552, 27549, 27545, 27542, 27538, 27535, 27531, 27528, 27524, 27521, 27517, 27514, 27510, 27507, 27503, 27500, 27496, 27493, 27489, 27486, 27482, 27479, 27475, 27472, 27468, 27464, 27461, 27457, 27454, 27450, 27447, 27443, 27440, 27436, 27433, 27429, 27426, 27422, 27419, 27415, 27412, 27408, 27405, 27401, 27398, 27394, 27391, 27387, 27384, 27380, 27377, 27373, 27370, 27366, 27363, 27359, 27356, 27352, 27349, 27345, 27342, 27338, 27335, 27331, 27328, 27324, 27321, 27317, 27314, 27310, 27307, 27303, 27300, 27296, 27293, 27289, 27286, 27282, 27279, 27275, 27272, 27268, 27265, 27261, 27258, 27254, 27251, 27247, 27244, 27240, 27237, 27233, 27230, 27226, 27223, 27219, 27216, 27212, 27209, 27205, 27202, 27198, 27195, 27191, 27188, 27184, 27181, 27177, 27174, 27170, 27167, 27163, 27160, 27156, 27153, 27149, 27146, 27142, 27139, 27135, 27132, 27128, 27125, 27121, 27118, 27114, 27111, 27108, 27104, 27101, 27097, 27094, 27090, 27087, 27083, 27080, 27076, 27073, 27069, 27066,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

// Switch High Gain Lut
// const uint32_t TempHG_LUT[4096] = {
// 27760, 27756, 27752, 27749, 27745, 27742, 27738, 27735, 27731, 27728, 27724, 27721, 27717, 27714, 27710, 27706, 27703, 27699, 27696, 27692, 27689, 27685, 27682, 27678, 27675, 27671, 27668, 27664, 27660, 27657, 27653, 27650, 27646, 27643, 27639, 27636, 27632, 27629, 27625, 27622, 27618, 27615, 27611, 27608, 27604, 27600, 27597, 27593, 27590, 27586, 27583, 27579, 27576, 27572, 27569, 27565, 27562, 27558, 27555, 27551, 27548, 27544, 27541, 27537, 27533, 27530, 27526, 27523, 27519, 27516, 27512, 27509, 27505, 27502, 27498, 27495, 27491, 27488, 27484, 27481, 27477, 27474, 27470, 27467, 27463, 27460, 27456, 27453, 27449, 27445, 27442, 27438, 27435, 27431, 27428, 27424, 27421, 27417, 27414, 27410, 27407, 27403, 27400, 27396, 27393, 27389, 27386, 27382, 27379, 27375, 27372, 27368, 27365, 27361, 27358, 27354, 27351, 27347, 27344, 27340, 27337, 27333, 27330, 27326, 27323, 27319, 27316, 27312, 27309, 27305, 27302, 27298, 27295, 27291, 27288, 27284, 27281, 27277, 27274, 27270, 27267, 27263, 27260, 27256, 27253, 27249, 27246, 27242, 27239, 27235, 27232, 27228, 27225, 27221, 27218, 27214, 27211, 27207, 27204, 27200, 27197, 27193, 27190, 27186, 27183, 27179, 27176, 27172, 27169, 27165, 27162, 27158, 27155, 27151, 27148, 27144, 27141, 27137, 27134, 27130, 27127, 27123, 27120, 27116, 27113, 27109, 27106, 27102, 27099, 27095, 27092, 27088, 27085, 27081, 27078, 27074, 27071, 27067, 27064, 27061, 27057, 27054, 27050, 27047, 27043, 27040, 27036, 27033, 27029, 27026, 27022, 27019, 27015, 27012,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

const uint32_t TempHG_LUT[4096] = {
2776, 2775, 2775, 2774, 2774, 2774, 2773, 2773, 2773, 2772, 2772, 2772, 2771, 2771, 2771, 2770, 2770, 2769, 2769, 2769, 2768, 2768, 2768, 2767, 2767, 2767, 2766, 2766, 2766, 2765, 2765, 2765, 2764, 2764, 2763, 2763, 2763, 2762, 2762, 2762, 2761, 2761, 2761, 2760, 2760, 2760, 2759, 2759, 2759, 2758, 2758, 2757, 2757, 2757, 2756, 2756, 2756, 2755, 2755, 2755, 2754, 2754, 2754, 2753, 2753, 2753, 2752, 2752, 2751, 2751, 2751, 2750, 2750, 2750, 2749, 2749, 2749, 2748, 2748, 2748, 2747, 2747, 2747, 2746, 2746, 2746, 2745, 2745, 2744, 2744, 2744, 2743, 2743, 2743, 2742, 2742, 2742, 2741, 2741, 2741, 2740, 2740, 2740, 2739, 2739, 2738, 2738, 2738, 2737, 2737, 2737, 2736, 2736, 2736, 2735, 2735, 2735, 2734, 2734, 2734, 2733, 2733, 2733, 2732, 2732, 2731, 2731, 2731, 2730, 2730, 2730, 2729, 2729, 2729, 2728, 2728, 2728, 2727, 2727, 2727, 2726, 2726, 2726, 2725, 2725, 2724, 2724, 2724, 2723, 2723, 2723, 2722, 2722, 2722, 2721, 2721, 2721, 2720, 2720, 2720, 2719, 2719, 2719, 2718, 2718, 2717, 2717, 2717, 2716, 2716, 2716, 2715, 2715, 2715, 2714, 2714, 2714, 2713, 2713, 2713, 2712, 2712, 2712, 2711, 2711, 2710, 2710, 2710, 2709, 2709, 2709, 2708, 2708, 2708, 2707, 2707, 2707, 2706, 2706, 2706, 2705, 2705, 2705, 2704, 2704, 2704, 2703, 2703, 2702, 2702, 2702, 2701, 2701, 2701, 2700, 2700, 2700, 2699, 2699, 2699, 2698, 2698, 2698, 2697, 2697, 2697, 2696, 2696, 2696, 2695, 2695, 2694, 2694, 2694, 2693, 2693, 2693, 2692, 2692, 2692, 2691, 2691, 2691, 2690, 2690, 2690, 2689, 2689, 2689, 2688, 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
1593, 1593, 1593, 1592, 1592, 1592, 1592, 1591, 1591, 1591, 1591, 1590, 1590, 1590, 1590, 1589, 1589, 1589, 1589, 1589, 1588, 1588, 1588, 1588, 1587, 1587, 1587, 1587, 1586, 1586, 1586, 1586, 1585, 1585, 1585, 1585, 1585, 1584, 1584, 1584, 1584, 1583, 1583, 1583, 1583, 1582, 1582, 1582, 1582, 1581, 1581, 1581, 1581, 1581, 1580, 1580, 1580, 1580, 1579, 1579, 1579, 1579, 1578, 1578, 1578, 1578, 1577, 1577, 1577, 1577, 1577, 1576, 1576, 1576, 1576, 1575, 1575, 1575, 1575, 1574, 1574, 1574, 1574, 1573, 1573, 1573, 1573, 1573, 1572, 1572, 1572, 1572, 1571, 1571, 1571, 1571 };

const uint32_t TempLG_LUT[4096] = {
2841, 2840, 2839, 2838, 2837, 2836, 2835, 2834, 2833, 2832, 2831, 2830, 2829, 2828, 2827, 2826, 2825, 2824, 2823, 2822, 2821, 2820, 2819, 2818, 2816, 2815, 2814, 2813, 2812, 2811, 2810, 2809, 2808, 2807, 2806, 2805, 2804, 2803, 2802, 2801, 2800, 2799, 2798, 2797, 2796, 2795, 2794, 2793, 2792, 2791, 2790, 2789, 2788, 2787, 2786, 2785, 2784, 2783, 2782, 2781, 2780, 2779, 2778, 2777, 2776, 2775, 2774, 2773, 2772, 2771, 2769, 2768, 2767, 2766, 2765, 2764, 2763, 2762, 2761, 2760, 2759, 2758, 2757, 2756, 2755, 2754, 2753, 2752, 2751, 2750, 2749, 2748, 2747, 2746, 2745, 2744, 2743, 2742, 2741, 2740, 2739, 2738, 2737, 2736, 2735, 2734, 2733, 2732, 2731, 2730, 2729, 2728, 2727, 2726, 2725, 2724, 2723, 2722, 2721, 2720, 2719, 2718, 2717, 2716, 2715, 2714, 2713, 2712, 2711, 2710, 2709, 2708, 2707, 2706, 2705, 2704, 2703, 2702, 2701, 2700, 2699, 2698, 2697, 2696, 2695, 2694, 2693, 2692, 2691, 2690, 2689, 2688, 2687, 2686, 2685, 2684, 2683, 2682, 2681, 2680, 2679, 2678, 2677, 2676, 2675, 2674, 2673, 2672, 2671, 2670, 2669, 2668, 2667, 2666, 2665, 2664, 2663, 2662, 2661, 2660, 2659, 2658, 2657, 2656, 2655, 2654, 2653, 2652, 2651, 2650, 2649, 2648, 2647, 2646, 2645, 2644, 2643, 2642, 2641, 2640, 2639, 2638, 2638, 2637, 2636, 2635, 2634, 2633, 2632, 2631, 2630, 2629, 2628, 2627, 2626, 2625, 2624, 2623, 2622, 2621, 2620, 2619, 2618, 2617, 2616, 2615, 2614, 2613, 2612, 2611, 2610, 2609, 2608, 2607, 2606, 2605, 2604, 2603, 2602, 2601, 2600, 2599, 2598, 2597, 2596, 2595, 2594, 2593, 2593, 2592, 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
};
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
