ATK-1/SeniorDesign_SwanGanz/firmware/SwanGanz/Schedule.h

#ifndef __SCHEDULE_H
#define __SCHEDULE_H  1

#include "DAS.h"
#include "Display.h"

#define PSCHEDULE_STARTMENU_SIZE 111
#define PSCHEDULE_ALLSAMPLES_SIZE 111

typedef struct {
    void (*periodicTask)(void);
    uint32_t timeToNext;
    uint32_t period;
} ptask_t;

typedef struct {
    const ptask_t* schedule;
    uint32_t scheulde_size;
} periodicScheduler_t; 

const ptask_t PSchedule_StartMenu[PSCHEDULE_STARTMENU_SIZE] = {
  {&DasStartMenu, 250, 200},          // 0
  {&InputPolling, 250, 20},           // 25
  {&HeartBeat, 500, 2},               // 50
  {&DasStartMenu, 1000, 200},         // 100
  {&DasStartMenu, 1000, 200},         // 200
  {&DasStartMenu, 1000, 200},         // 300
  {&DasStartMenu, 1000, 200},         // 400
  {&DasStartMenu, 1000, 200},         // 500
  {&DasStartMenu, 1000, 200},         // 600
  {&DasStartMenu, 1000, 200},         // 700
  {&DasStartMenu, 1000, 200},         // 800
  {&DasStartMenu, 1000, 200},         // 900
  {&DasStartMenu, 250, 200},          // 1000
  {&InputPolling, 750, 20},           // 1025
  {&DasStartMenu, 1000, 200},         // 1100
  {&DasStartMenu, 1000, 200},         // 1200
  {&DasStartMenu, 1000, 200},         // 1300
  {&DasStartMenu, 1000, 200},         // 1400
  {&DasStartMenu, 1000, 200},         // 1500
  {&DasStartMenu, 1000, 200},         // 1600
  {&DasStartMenu, 1000, 200},         // 1700
  {&DasStartMenu, 1000, 200},         // 1800
  {&DasStartMenu, 1000, 200},         // 1900
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
  {&DasAllSamples, 1000, 200},        // 9800
  {&DasAllSamples, 1000, 200}         // 9900
};

const periodicScheduler_t FixedSchedule[2] = {
    {PSchedule_StartMenu, PSCHEDULE_STARTMENU_SIZE},
    {PSchedule_AllSamples, PSCHEDULE_ALLSAMPLES_SIZE}
};

#endif
