ATK-1/SeniorDesign_SwanGanz/firmware/SwanGanz/Conversions.h

#ifndef __CONVERSIONS_H__
#define __CONVERSIONS__  1

void FiveDigDecUIntToFixedStr(uint32_t val, char* str);
void FourDigDecUIntToFixedStr(uint32_t val, char* str);

void FourDigUIntToFixedStr(int32_t val, char* str);
void ThreeDigUIntToFixedStr(int32_t val, char* str);

#endif
