ATK-1/SeniorDesign_SwanGanz/firmware/SwanGanz/inc/SPI.h

/*!
 * @defgroup SPI
 * @brief Synchronous serial communication
 <table>
<caption id="SPIpins">SPI-LCD pins </caption>
<tr><th>Pin <th>Function  <th>Description
<tr><td>PB9 <td>SPI1 SCLK <td>J1.7 LCD SPI clock (SPI)   
<tr><td>PB6 <td>SPI1 CS0  <td>J2.13 LCD SPI CS (SPI)     
<tr><td>PB8 <td>SPI1 PICO <td>J2.15 LCD SPI data (SPI)    
<tr><td>PB15<td>GPIO      <td>J2.17 LCD !RST =1 for run, =0 for reset   
<tr><td>PA13<td>GPIO      <td>J4.31 LCD RS =1 for data, =0 for command   
</table>
 * @{*/
/**
 * @file      SPI.h
 * @brief     Synchronous serial communication
 * @details   SPI uses a chip select, clock, data out and data in. This interface does not use data in.
 * This interface can be used for MKII LCD and the ST7735R LCD
 * \image html SPIinterface.png  width=500px
 * @version   ECE319K v1.2
 * @author    Daniel Valvano and Jonathan Valvano
 * @copyright Copyright 2025 by Jonathan W. Valvano, valvano@mail.utexas.edu,
 * @warning   AS-IS
 * @note      For more information see  http://users.ece.utexas.edu/~valvano/
 * @date      July 19, 2025
 <table>
<caption id="SPIpins2">SPI-LCD pins </caption>
<tr><th>Pin <th>Function  <th>Description
<tr><td>PB9 <td>SPI1 SCLK <td>J1.7 LCD SPI clock (SPI)   
<tr><td>PB6 <td>SPI1 CS0  <td>J2.13 LCD SPI CS (SPI)     
<tr><td>PB8 <td>SPI1 PICO <td>J2.15 LCD SPI data (SPI)    
<tr><td>PB15<td>GPIO      <td>J2.17 LCD !RST =1 for run, =0 for reset  
<tr><td>PA13<td>GPIO      <td>J4.31 LCD RS =1 for data, =0 for command   
</table>
  ******************************************************************************/
#ifndef __SPI_H__
#define __SPI_H__
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
