ATK-1/SeniorDesign_SwanGanz/(commit log)

2025-12-18 Initial Hardware Commit
    [SwanGanzInterface.kicad_pcb, SwanGanzInterface.kicad_sch]
2025-12-20 Base Config for Hardware KiCad project
    [SGI_Power.kicad_sch, SGI_PressureChannel1.kicad_sch, SGI_PressureChannel2.kicad_sch, SGI_Processor.kicad_sch, SGI_Thermistor.kicad_sch, SwanGanzInterface.kicad_sch]
2025-12-21 Added INA122 and OPA2350 in Part Libs, Implimented INA122 in Thermistor Circuit
    [SGI_Thermistor.kicad_sch]
2025-12-22 Developed amplifier circuits
    [SGI_Power.kicad_sch, SGI_PressureChannel1.kicad_sch, SGI_PressureChannel2.kicad_sch, SGI_Thermistor.kicad_sch]
2025-12-22 Fixed kicad open
2025-12-23 Changed location of lib files, added microcontroller schematic
    [SGI_Power.kicad_sch, SGI_PressureChannel1.kicad_sch, SGI_Processor.kicad_sch]
2025-12-23 Closed Kicad
    [SGI_Power.kicad_sch, SGI_Processor.kicad_sch]
2026-01-12 Filter Parameters
    [SGI_Power.kicad_sch, SGI_PressureChannel1.kicad_sch, SGI_PressureChannel2.kicad_sch, SGI_Processor.kicad_sch, SGI_Thermistor.kicad_sch, SwanGanzInterface.kicad_sch]
2026-01-13 Started msp0 symbol
    [SGI_Processor.kicad_sch, SGI_Thermistor.kicad_sch]
2026-01-13 Finished MSP-LP Symbol, Started Pressure_Connector Symbol
    [SGI_Power.kicad_sch, SGI_PressureChannel1.kicad_sch, SGI_PressureChannel2.kicad_sch, SGI_Processor.kicad_sch]
2026-01-14 Pressure Connector - Syncing for development
    [SGI_PressureChannel1.kicad_sch, SGI_Processor.kicad_sch]
2026-01-14 Updated gain and added power connector
    [SGI_Power.kicad_sch, SGI_PressureChannel1.kicad_sch, SGI_PressureChannel2.kicad_sch, SGI_Processor.kicad_sch, SGI_Thermistor.kicad_sch]
2026-01-16 Reverse Polarity Fet, Updated Notes, Added second gain stage for pressure, General Updates
    [SGI_Power.kicad_sch, SGI_PressureChannel1.kicad_sch, SGI_PressureChannel2.kicad_sch, SGI_Processor.kicad_sch, SGI_Thermistor.kicad_sch]
2026-01-21 Added launchpad, power jumpers, messed with symbol lib
    [SGI_Power.kicad_sch, SGI_PressureChannel1.kicad_sch, SGI_PressureChannel2.kicad_sch, SGI_Processor.kicad_sch, SGI_Thermistor.kicad_sch, SwanGanzInterface.kicad_pcb]
2026-01-23 Routed Microcontroller Schematic Pins
    [SGI_PressureChannel1.kicad_sch, SGI_PressureChannel2.kicad_sch, SGI_Processor.kicad_sch, SGI_Thermistor.kicad_sch]
2026-01-23 Added Test Points to the Outputs of Analog Circuits
    [SGI_Power.kicad_sch, SGI_PressureChannel1.kicad_sch, SGI_PressureChannel2.kicad_sch, SGI_Processor.kicad_sch, SGI_Thermistor.kicad_sch]
2026-01-26 Footprints for most parts, added LCD Driver
    [SGI_Power.kicad_sch, SGI_PressureChannel1.kicad_sch, SGI_PressureChannel2.kicad_sch, SGI_Processor.kicad_sch, SGI_Thermistor.kicad_sch, SwanGanzInterface.kicad_pcb]
2026-01-27 Consolidated Grounds
    [SGI_Power.kicad_sch, SGI_PressureChannel1.kicad_sch, SGI_PressureChannel2.kicad_sch, SGI_Thermistor.kicad_sch, SwanGanzInterface.kicad_pcb]
2026-01-29 Updated Pressure Gain
    [SGI_PressureChannel1.kicad_sch, SGI_PressureChannel2.kicad_sch]
2026-02-02 Started Layout
    [SGI_Power.kicad_sch, SGI_Processor.kicad_sch, SGI_Thermistor.kicad_sch, SwanGanzInterface.kicad_pcb]
2026-02-02 Started Routing
    [SGI_PressureChannel1.kicad_sch, SGI_PressureChannel2.kicad_sch, SGI_Processor.kicad_sch, SGI_Thermistor.kicad_sch, SwanGanzInterface.kicad_pcb]
2026-02-02 Valvano Changes
    [SGI_Processor.kicad_sch, SwanGanzInterface.kicad_pcb]
2026-02-02 Reannotated symbols
    [SGI_Power.kicad_sch, SGI_PressureChannel1.kicad_sch, SGI_PressureChannel2.kicad_sch, SGI_Processor.kicad_sch, SGI_Thermistor.kicad_sch]
2026-02-04 Finished Layout - Requires check and silkscreen
    [SGI_Processor.kicad_sch, SwanGanzInterface.kicad_pcb]
2026-02-04 Created BOM template file
    [SGI_BOM_v1.0.xlsx]
2026-02-06 Finished Layout :D
    [SGI_Power.kicad_sch, SwanGanzInterface.kicad_pcb]
2026-02-06 Production Files
    [bom.csv, designators.csv, positions.csv]
2026-02-06 Fixed production files
    [SwanGanzInterface.kicad_pcb]
2026-02-09 Fixed reference size
    [SwanGanzInterface.kicad_pcb]
2026-02-09 Fixed butterworth filters
    [SGI_PressureChannel1.kicad_sch, SGI_PressureChannel2.kicad_sch, SGI_Thermistor.kicad_sch, SwanGanzInterface.kicad_pcb]
2026-02-10 Implemented Jack's new pressure footprint and added teardrop - new production file
    [SGI_PressureChannel1.kicad_sch, SGI_PressureChannel2.kicad_sch, SwanGanzInterface.kicad_pcb, bom.csv, positions.csv]
2026-02-11 Driver Power
    [SGI_PressureChannel1.kicad_sch, SGI_PressureChannel2.kicad_sch, SGI_Processor.kicad_sch, SGI_Thermistor.kicad_sch, SwanGanzInterface.kicad_pcb]
2026-02-11 Prod files
    [SwanGanzInterface.kicad_pcb, bom.csv, designators.csv, positions.csv]
2026-02-17 Added Jerry's BOM
    [SGI_BOM_v1.0.xlsx]
2026-02-17 Added Purchase Request
    [PurchaseRequest_FH02_2_17_2026.xlsx]
2026-02-17 fixed references on BOM
    [SGI_BOM_v1.0.xlsx]
2026-02-17 Updated Purchase Request
    [PurchaseRequest_FH02_2_17_2026.xlsx]
2026-02-20 adc sampling
    [fftdesign.xlsx]
2026-02-20 ADC working temp
2026-02-21 fixed setting CTL.ENC0 before writing to MEMCTL[y] causing adc not to work
    [ADC.c, ADC.h, DAS.c]
2026-02-22 tested each pin with the adc, fixed wrong channel notation for pa17 and pa18. confirmed all channels are be sampled correctly
    [ADC.c, DAS.c]
2026-02-26 make adc sample closer to the same time
2026-02-27 fixed watch variables and lcd
    [DAS.c, SPI.c]
2026-02-27 de;eted launch.json
2026-03-04 added threads, modified OS to work with senior design project including fifos and timerg8, added fixed schedule for needed periodic threads
    [ADC.c, ADC.h, DAS.c, DAS.h, Display.c, Display.h, FIFO.c, OS.c]
2026-03-04 Debugged RTOS, thread switching, statically alocated semaphores, got stuff done for Dennis meeting
2026-03-04 cleaned up lcd bugs
    [DAS.c, Display.c]
2026-03-05 Set hardware averaging to 4 samples right shifted by 2, created TempLUT and basic output of it
2026-03-06 fixed schedule and timer
    [DAS.c, Display.c, Display.h, LUT.h, OS.c, OS.h, main.c]
2026-03-12 Created kicad project files for SGI v1.1
    [SGI_BOM_v1.0.xlsx, SGI_Power.kicad_sch, SGI_PressureChannel1.kicad_sch, SGI_PressureChannel2.kicad_sch, SGI_Processor.kicad_sch, SGI_Thermistor.kicad_sch, SwanGanzInterface_V1.1.kicad_pcb, SwanGanzInterface_V1.1.kicad_sch]
2026-03-13 Started Pin Allocation
    [SGI_BOM_v1.0.xlsx, SwanGanzInterface_v1.1_PinAllocation.xlsx]
2026-03-13 low level functions for RA8875 driver
2026-03-17 finished translating driver to C
2026-03-18 Worked on pin allocation
    [PurchaseRequest_FH02_2_17_2026.xlsx, SwanGanzInterface_v1.1_PinAllocation.xlsx]
2026-03-19 More pin allocation
    [SwanGanzInterface_v1.1_PinAllocation.xlsx]
2026-03-19 Pin Allocation, updated schematic with new pins, reassigned
    [FT232.kicad_sch, SGI_Power.kicad_sch, SGI_PressureChannel1.kicad_sch, SGI_PressureChannel2.kicad_sch, SGI_Processor.kicad_sch, SGI_Thermistor.kicad_sch, Speaker.kicad_sch, SwanGanzInterface_V1.1.kicad_sch]
2026-03-21 Added MSP symbol/footprint
    [SGI_Processor.kicad_sch]
2026-03-23 Hooked up MSP
    [FT232.kicad_sch, SGI_PressureChannel1.kicad_sch, SGI_PressureChannel2.kicad_sch, SGI_Processor.kicad_sch, SGI_Thermistor.kicad_sch, SwanGanzInterface_v1.1_PinAllocation.xlsx]
2026-03-23 Worked on FT232R circuit - RTS, CTS etc
    [FT232.kicad_sch, SGI_Processor.kicad_sch, SwanGanzInterface_v1.1_PinAllocation.xlsx]
2026-03-23 Added crystal loading caps
    [FT232.kicad_sch, SGI_Processor.kicad_sch, Speaker.kicad_sch]
2026-03-24 Added work on FT232, added transmit and receieve leds
    [FT232.kicad_sch, SGI_Processor.kicad_sch, SwanGanzInterface_V1.1.kicad_pcb]
2026-03-24 Added audio ampliier to symbol lib, began converting speaker circuit to audio amplifier
    [Speaker.kicad_sch]
2026-03-24 Calculated speaker gain
    [Speaker.kicad_sch]
2026-03-25 debugging spi
2026-03-26 Delayed SPI POCI sampling, fixing SPI communication with RA8875
    [Display.c, RA8875.c, SPI.c]
2026-03-28 Started converting things to use touch screen chip
    [AuxiliaryDevices.kicad_sch, FT232.kicad_sch, SGI_Power.kicad_sch, SGI_PressureChannel1.kicad_sch, SGI_PressureChannel2.kicad_sch, SGI_Processor.kicad_sch, SGI_Thermistor.kicad_sch, SwanGanzInterface_V1.1.kicad_sch]
2026-03-29 Added lots, moving to 64 pin micro
    [AuxiliaryDevices.kicad_sch, SGI_Power.kicad_sch, SGI_Processor.kicad_sch, SGI_Thermistor.kicad_sch, Speaker.kicad_sch, SwanGanzInterface_v1.1_PinAllocation.xlsx]
2026-03-29 Got 64 pin MSP symbol and footprint and started implementation
    [AuxiliaryDevices.kicad_sch, SGI_PressureChannel1.kicad_sch, SGI_PressureChannel2.kicad_sch, SGI_Processor.kicad_sch, Speaker.kicad_sch, SwanGanzInterface_v1.1_PinAllocation.xlsx]
2026-03-29 Added debug pins to touch ic and ft232
    [AuxiliaryDevices.kicad_sch, SGI_Processor.kicad_sch, Speaker.kicad_sch, SwanGanzInterface_v1.1_PinAllocation.xlsx]
2026-03-30 LCD spi debugging pins
    [AuxiliaryDevices.kicad_sch, SGI_Power.kicad_sch, Speaker.kicad_sch]
2026-03-31 Schematic Check
    [AuxiliaryDevices.kicad_sch, SGI_Power.kicad_sch, SGI_PressureChannel1.kicad_sch, SGI_PressureChannel2.kicad_sch, SGI_Processor.kicad_sch, SGI_Thermistor.kicad_sch, Speaker.kicad_sch, SwanGanzInterface_v1.1_PinAllocation.xlsx]
2026-03-31 Filter paramaters and assigned footprints
    [AuxiliaryDevices.kicad_sch, SGI_Power.kicad_sch, SGI_PressureChannel1.kicad_sch, SGI_PressureChannel2.kicad_sch, SGI_Processor.kicad_sch, SGI_Thermistor.kicad_sch, Speaker.kicad_sch, SwanGanzInterface_V1.1.kicad_pcb]
2026-04-01 Block Diagram for Layout
    [SGI_Processor.kicad_sch, SwanGanzInterface_V1.1.kicad_pcb, SwanGanzInterface_v1.1_PinAllocation.xlsx]
2026-04-02 Layout Part 1
    Pressure, Audio, Thermistor
    [SGI_PressureChannel1.kicad_sch, SGI_Thermistor.kicad_sch, SwanGanzInterface_V1.1.kicad_pcb]
2026-04-02 Started MCU layout
    [SwanGanzInterface_V1.1.kicad_pcb]
2026-04-03 Layout work on screen and expanded board size
    [AuxiliaryDevices.kicad_sch, SGI_Power.kicad_sch, SGI_PressureChannel1.kicad_sch, SGI_Processor.kicad_sch, Speaker.kicad_sch, SwanGanzInterface_V1.1.kicad_pcb]
2026-04-03 Button pin allocation, layout of power and ft, general layout
    [AuxiliaryDevices.kicad_sch, SGI_Processor.kicad_sch, SwanGanzInterface_V1.1.kicad_pcb, SwanGanzInterface_v1.1_PinAllocation.xlsx]
2026-04-03 Digital Traces
    [AuxiliaryDevices.kicad_sch, SGI_Processor.kicad_sch]
2026-04-03 Updated footprint
2026-04-03 SGI v2 Layout Complete
    [AuxiliaryDevices.kicad_sch, SGI_Power.kicad_sch, SGI_PressureChannel1.kicad_sch, SGI_PressureChannel2.kicad_sch, SGI_Processor.kicad_sch, SGI_Thermistor.kicad_sch, Speaker.kicad_sch]
2026-04-03 Created Gerbers
    [bom.csv, designators.csv, positions.csv]
2026-04-11 Finished Drivers and basic spi test
2026-04-13 rust and js code to update graphs as we receive data. firmware fixes to send uart
    [lib.rs, state.rs]
2026-04-14 firmware to work with uart testing
2026-04-19 start button and fixed pressure 2
    [Display.c]
2026-04-20 Touch Screen working - Bug fix in driver decode, created buttons for start screen -- tested
    [DAS.c, DAS.h, Display.c, TSC2046IPWR.c, TSC2046IPWR.h, TouchControl.c, main.c]
2026-04-21 Revert "injectate progress bar"
    This reverts commit 3a4299ef347ac28ab8f038d46f8d38c73aaf2a22.
    [Display.c, OS.c]
2026-04-22 fixed charts not moving with window size
    [lib.rs]
2026-04-22 updated lcd to show adc values in start screen
2026-04-24 added units to pressure, recentered data, allowed for dynamic change of digits for pressure readings
2026-04-24 tested and fixed connection status for LCD to laptop
    [Data.c, Display.c]
2026-04-24 made connection to UART from laptop more robust
2026-04-25 i did so much idek how to make this commit, hard faulting when adding back threads beacuse the const string in display connected is null for some reason
2026-04-26 implemented reset, fixed threads not killing themselves causing fifo to run out of TCBs
    [Display.c, DisplayStartMenu.c, OS.h, main.c]
2026-04-26 current readings on thermodilution screen
2026-04-26 added styling to csv input box and button
2026-04-26 added reset button for graphs
2026-04-27 Fixed reset button, added comments to touch screen driver, some unit stuff
    [Data.c, LUT.h, TSC2046IPWR.c, TSC2046IPWR.h, TouchControl.c]
2026-04-27 fixed graph reset not working, changed to 400hz sample, changed LUT resolution
    [Data.c, Display.c, LUT.h, OS.c, lib.rs]
2026-07-19 Hardware README.md - Analog Stages, user interface
